martinerk0/dustbot/future.md

Future improvements could include:
-velcro or magnets to remove rag
-brush with motor instead of rag
-ultrasound sensors
-proper caster (or brush at front)
-more processing power (Rpi 4 or Nvidia Jetson Nano)
-stronger motors with better wheels

[Link to a page](index.md)
