martinerk0/dustbot/images/arduino.png

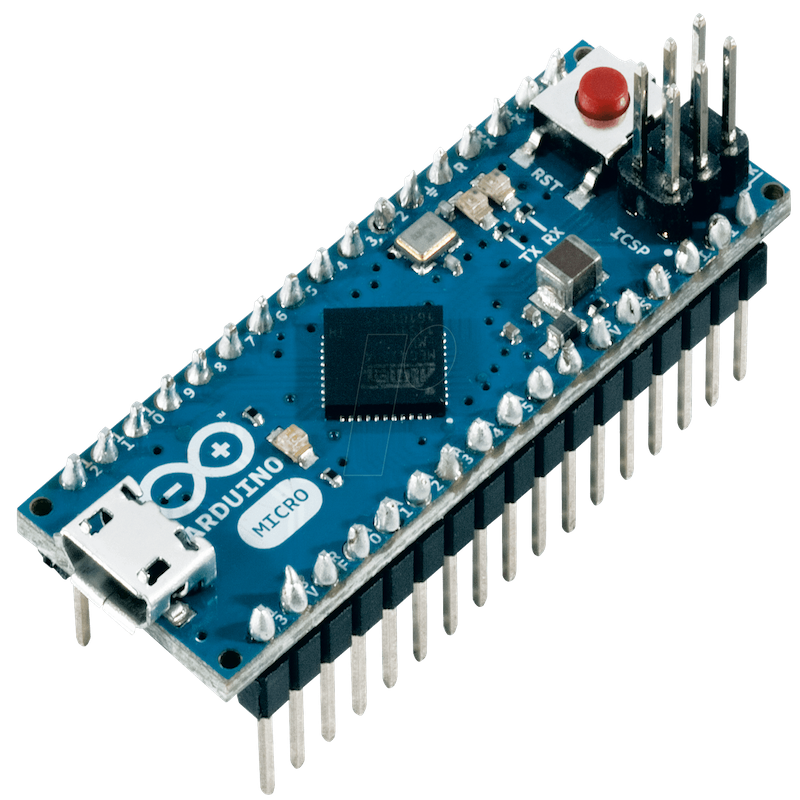
images/arduino.png
