martinerk0/dustbot/images/back.jpg

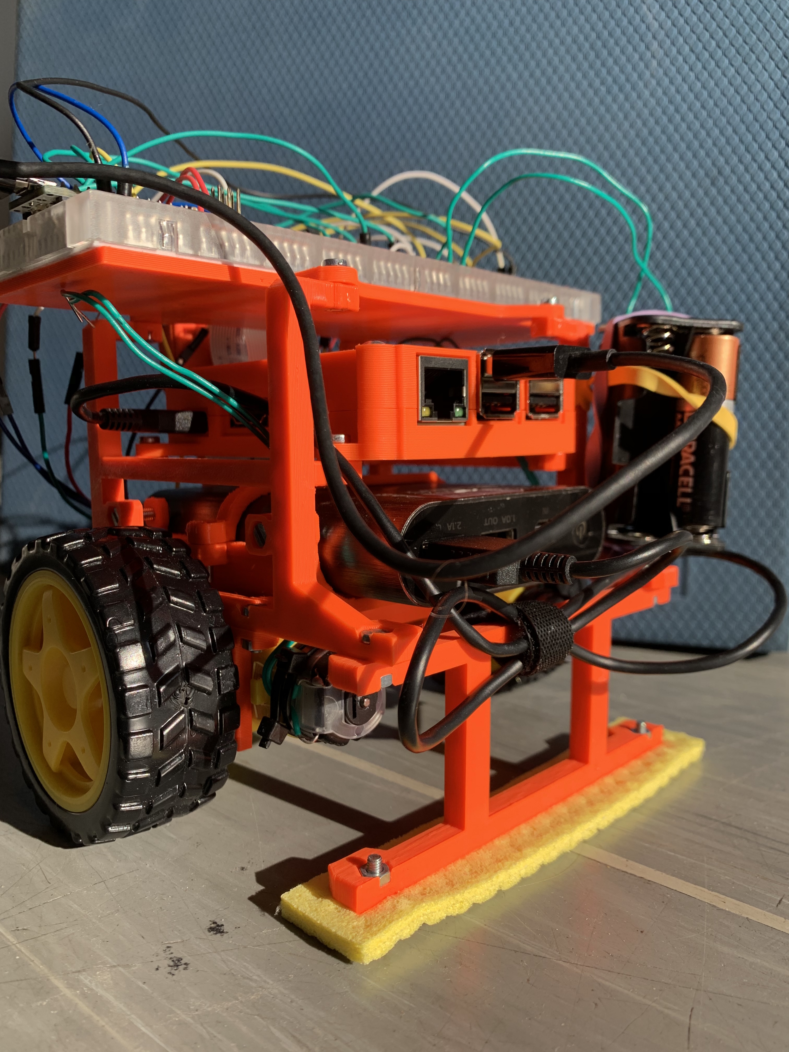
images/back.jpg
