martinerk0/dustbot/images/chip.jpeg

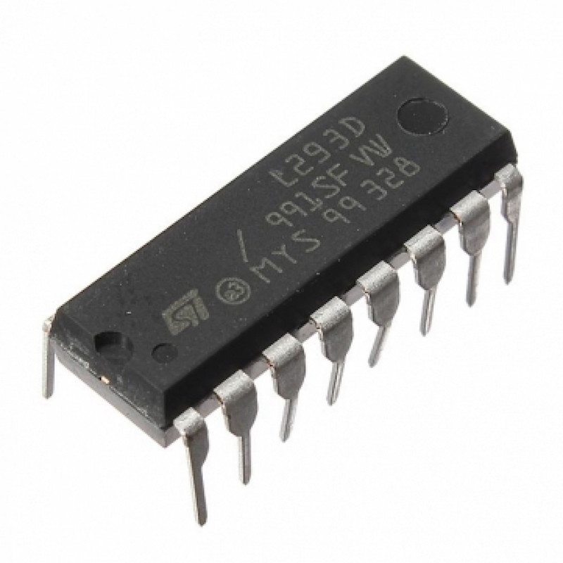
images/chip.jpeg
