martinerk0/dustbot/images/jetson.jpg

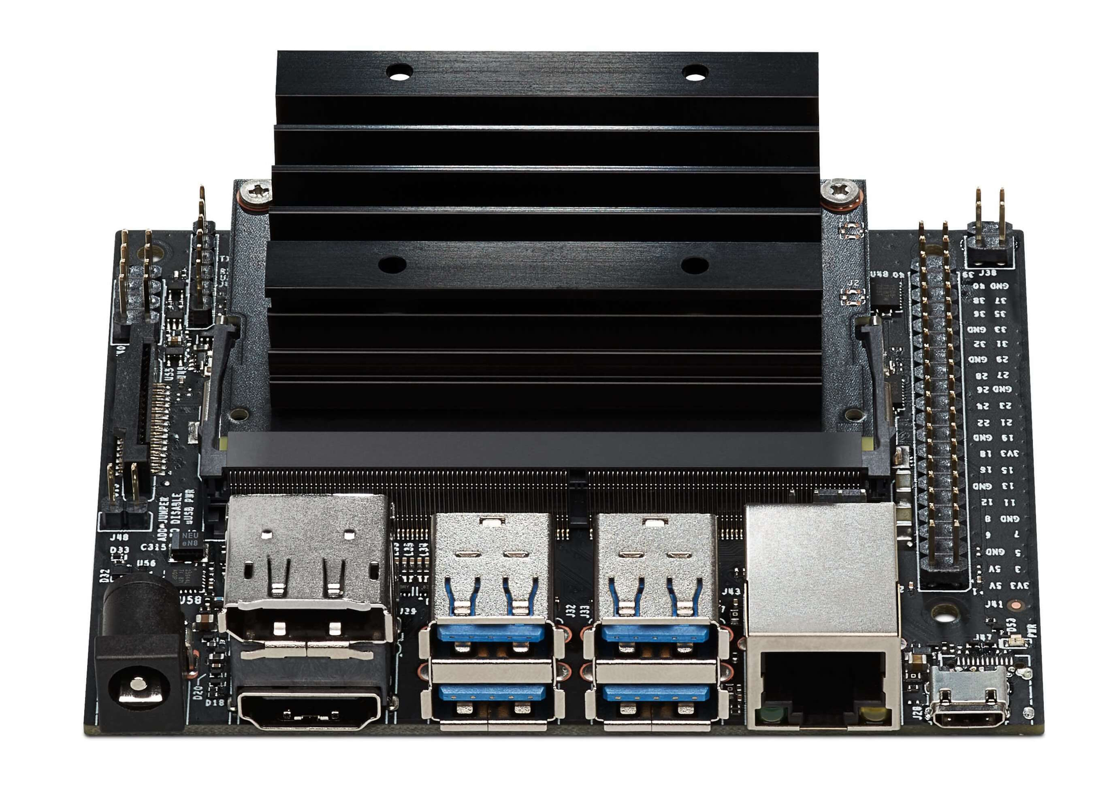
images/jetson.jpg
