martinerk0/dustbot/images/pejsek_watermark.png

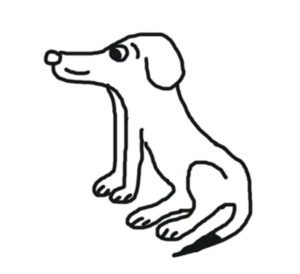
images/pejsek_watermark.png
