martinerk0/dustbot/images/rpi.jpg

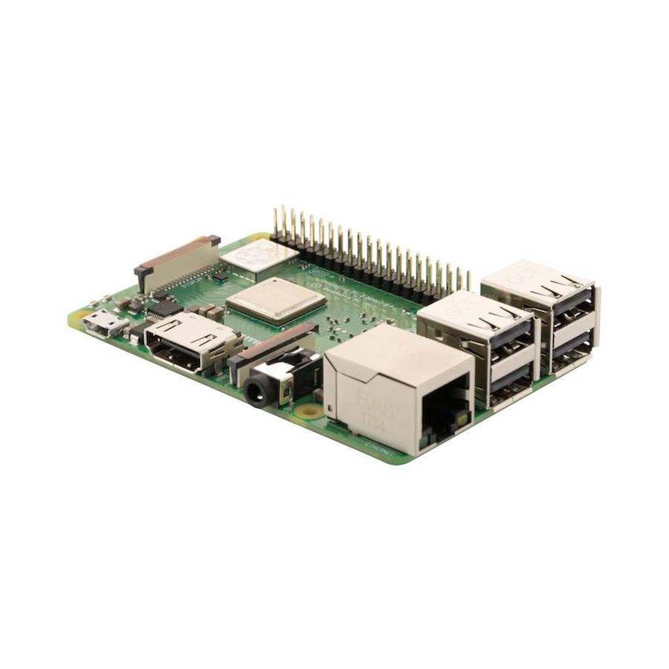
images/rpi.jpg
