martinerk0/dustbot/images/s-l300.jpg

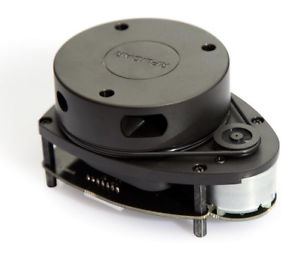
images/s-l300.jpg
