martinerk0/dustbot/images/side.png

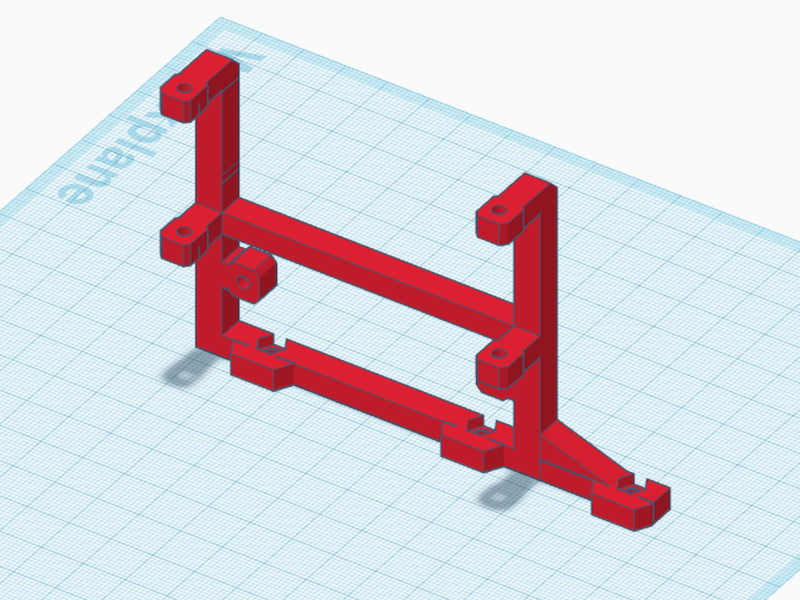
images/side.png
