martinerk0/dustbot/models/dustbot_battery.stl

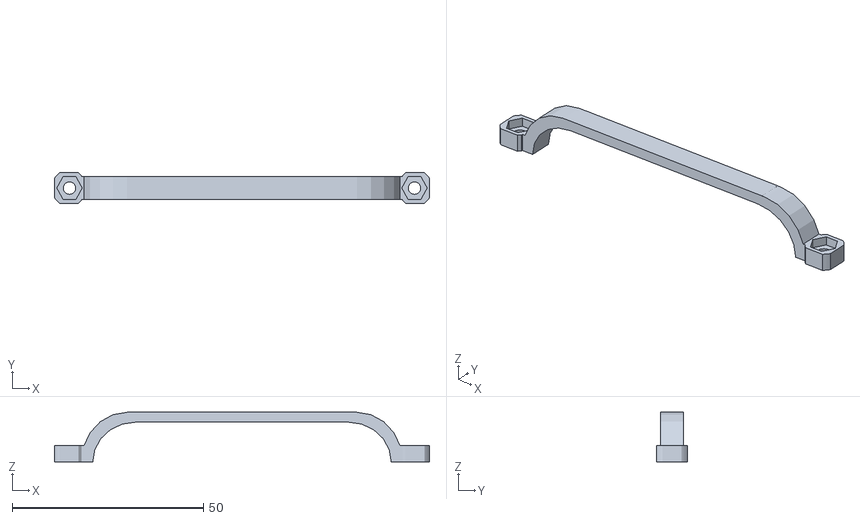
[picture p15: CAD file, 2019-09-20]
models/dustbot_battery.stl
98.0 x 7.99 x 13.0
