martinerk0/dustbot/models/BreadBoard_holder.stl

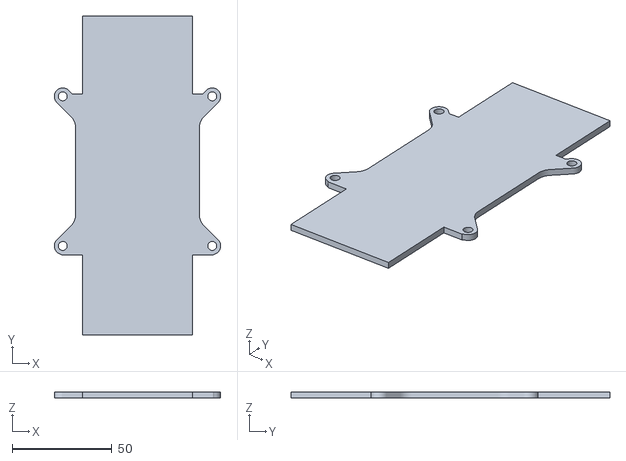
[picture p16: CAD file, 2019-09-20]
models/BreadBoard_holder.stl
83.5 x 160.0 x 3.00
