martinerk0/dustbot/models/dustbot_battery2.stl

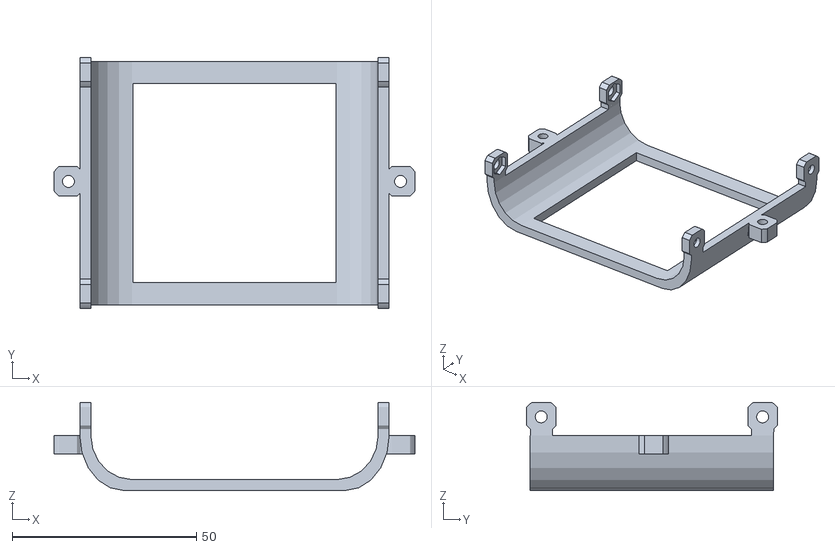
[picture p17: CAD file, 2019-09-20]
models/dustbot_battery2.stl
98.0 x 68.1 x 23.9
