martinerk0/dustbot/models/dustbot_bottom.stl

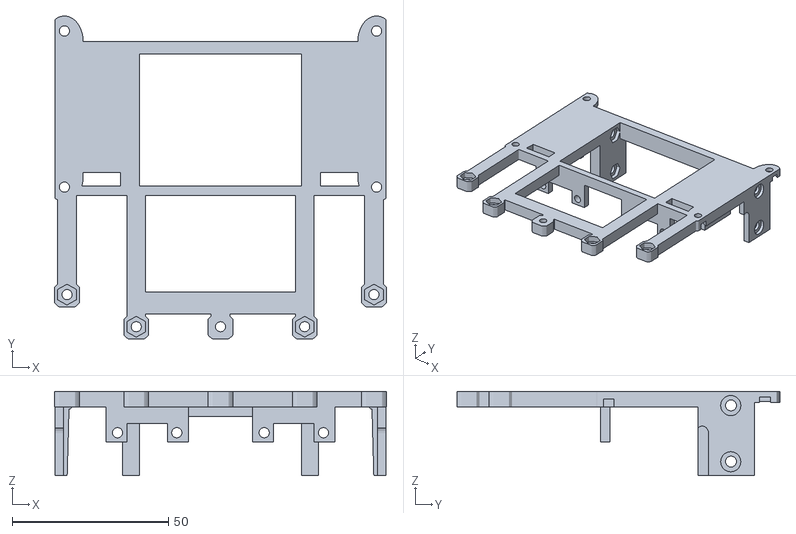
[picture p18: CAD file, 2019-09-20]
models/dustbot_bottom.stl
106.4 x 103.5 x 27.0
