martinerk0/dustbot/models/dustbot_side.stl

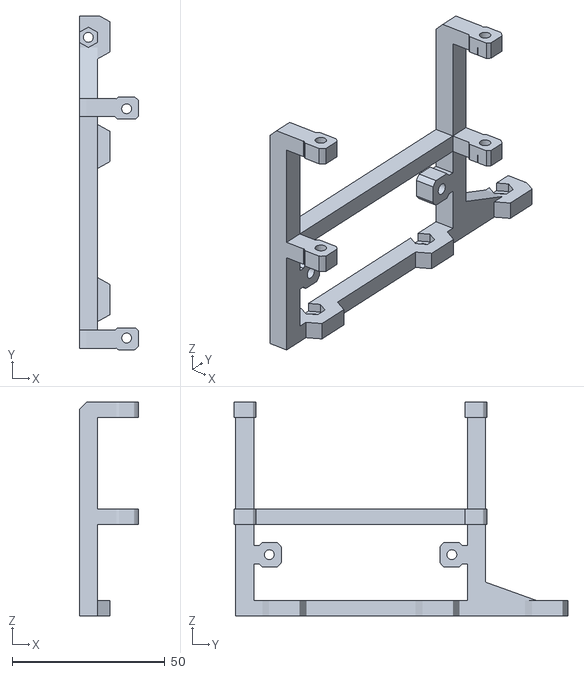
[picture p19: CAD file, 2019-09-20]
models/dustbot_side.stl
19.5 x 109.5 x 70.0
