martinerk0/dustbot/models/wheel_encoder.stl

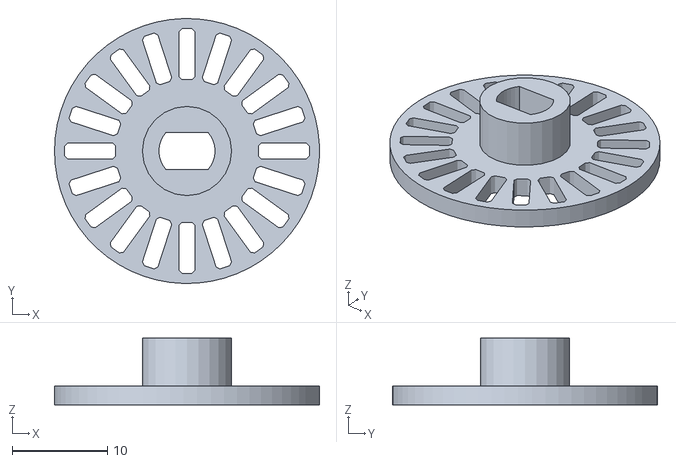
[picture p20: CAD file, 2019-09-20]
models/wheel_encoder.stl
27.8 x 27.8 x 7.00
