martinerk0/dustbot/models/dustbot_rear.stl

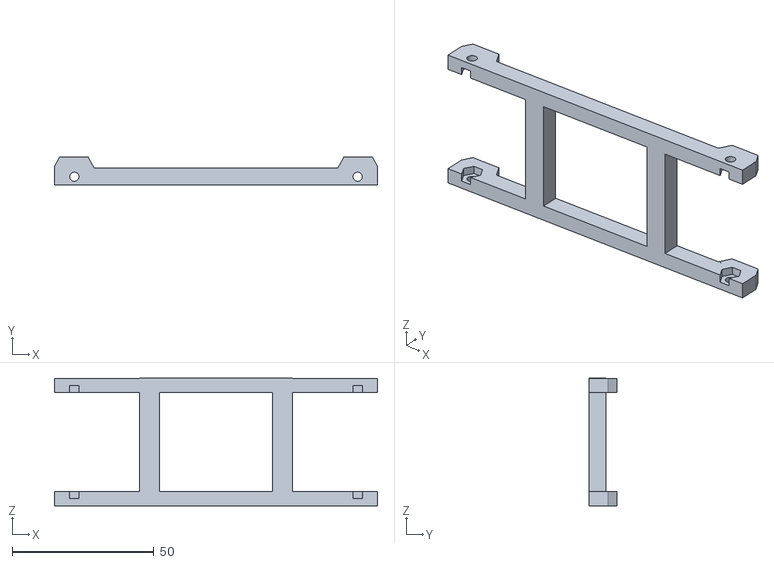
[picture p21: CAD file, 2019-09-20]
models/dustbot_rear.stl
114.0 x 10.00 x 45.0
