martinerk0/dustbot/(commit log)

2019-09-20 models
    added models
    [BreadBoard_holder.stl, dustbot_battery.stl, dustbot_battery2.stl, dustbot_bottom.stl, dustbot_rear.stl, dustbot_side.stl, wheel_encoder.stl]
2019-09-20 Update index.md
    motor image
